Relsart/WaterLeakDefence_AVR/documentation/Schematics.pdf

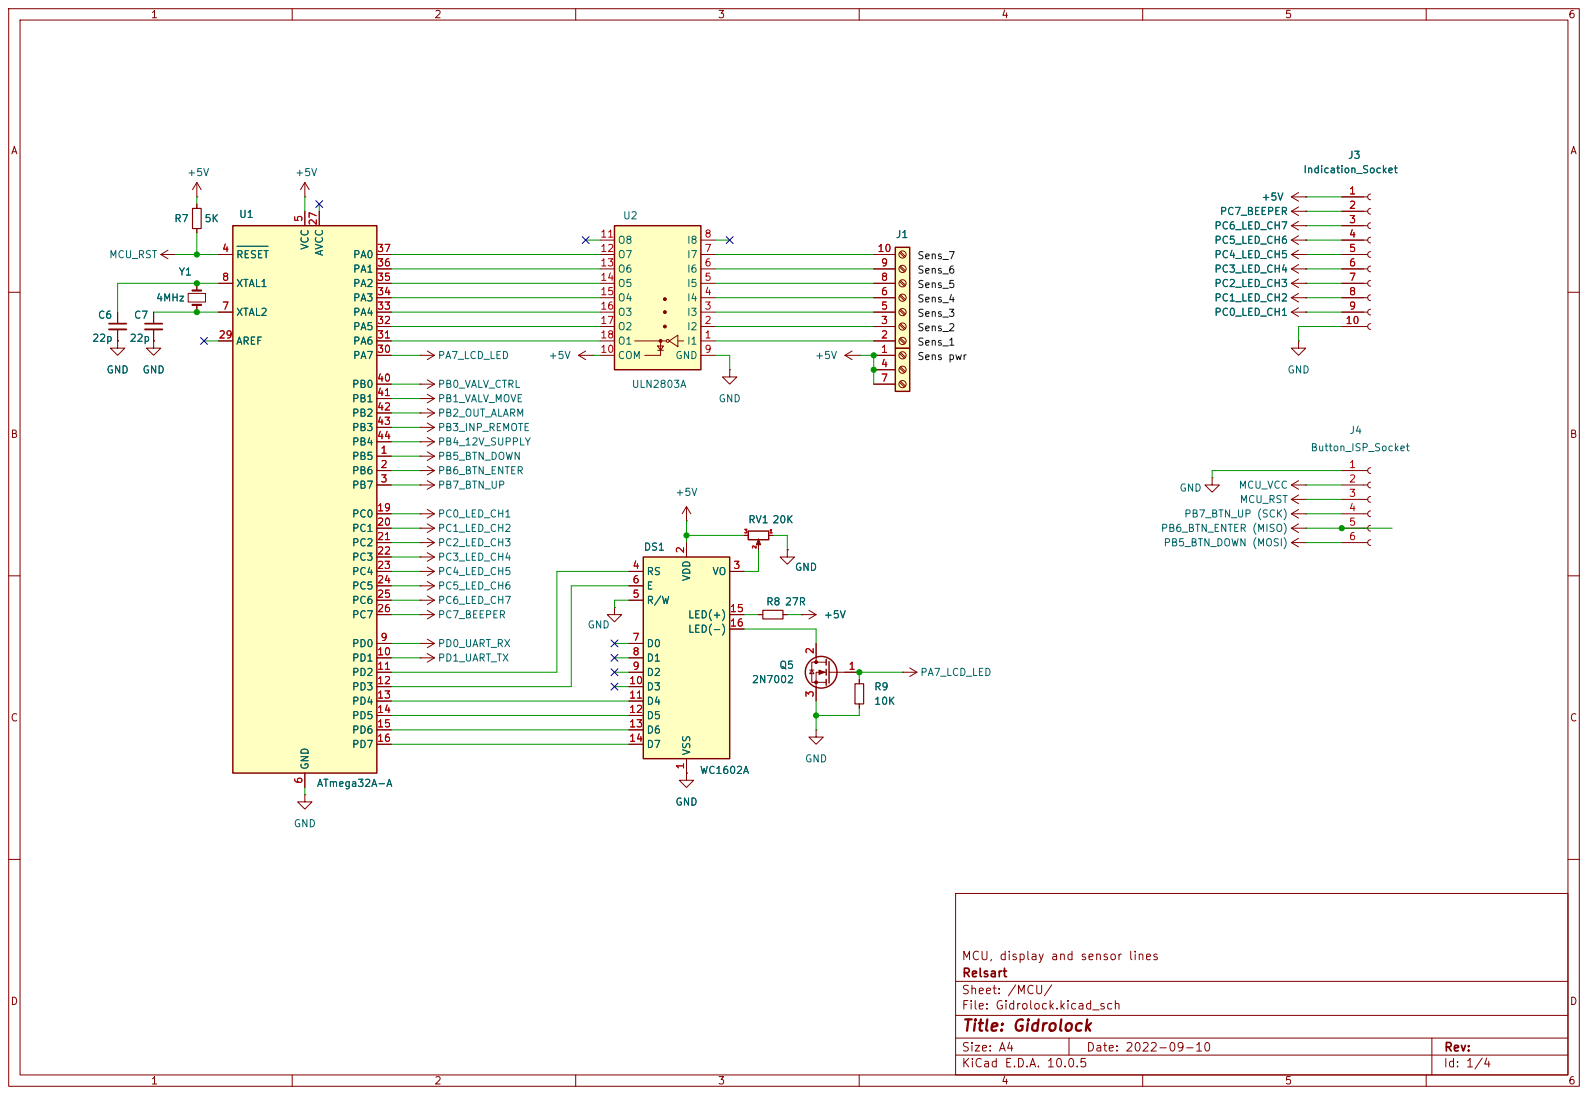
[picture p2: page 1]

MCU, display and sensor lines
Relsart
Sheet: /MCU/
File: Gidrolock.kicad_sch
Title: Gidrolock

Size: A4 | Rev:
KiCad E.D.A. 10.0.5 | Id: 1/4

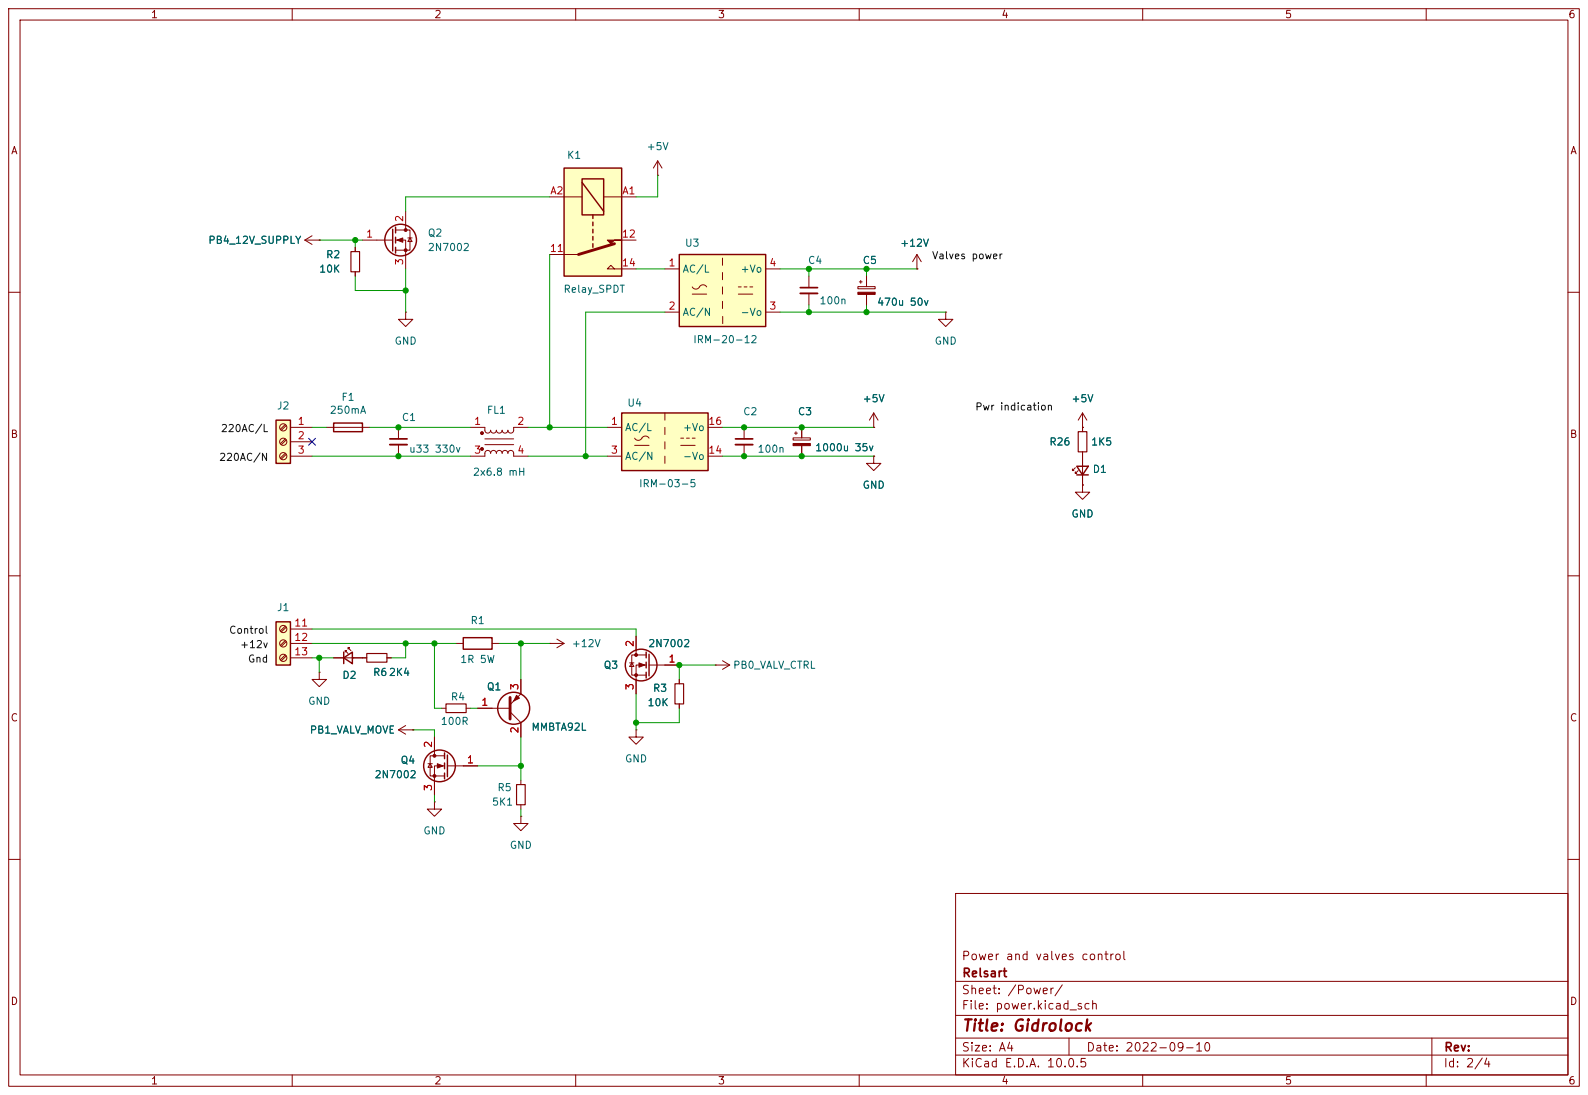
[picture p3: page 2]

Power and valves control R1

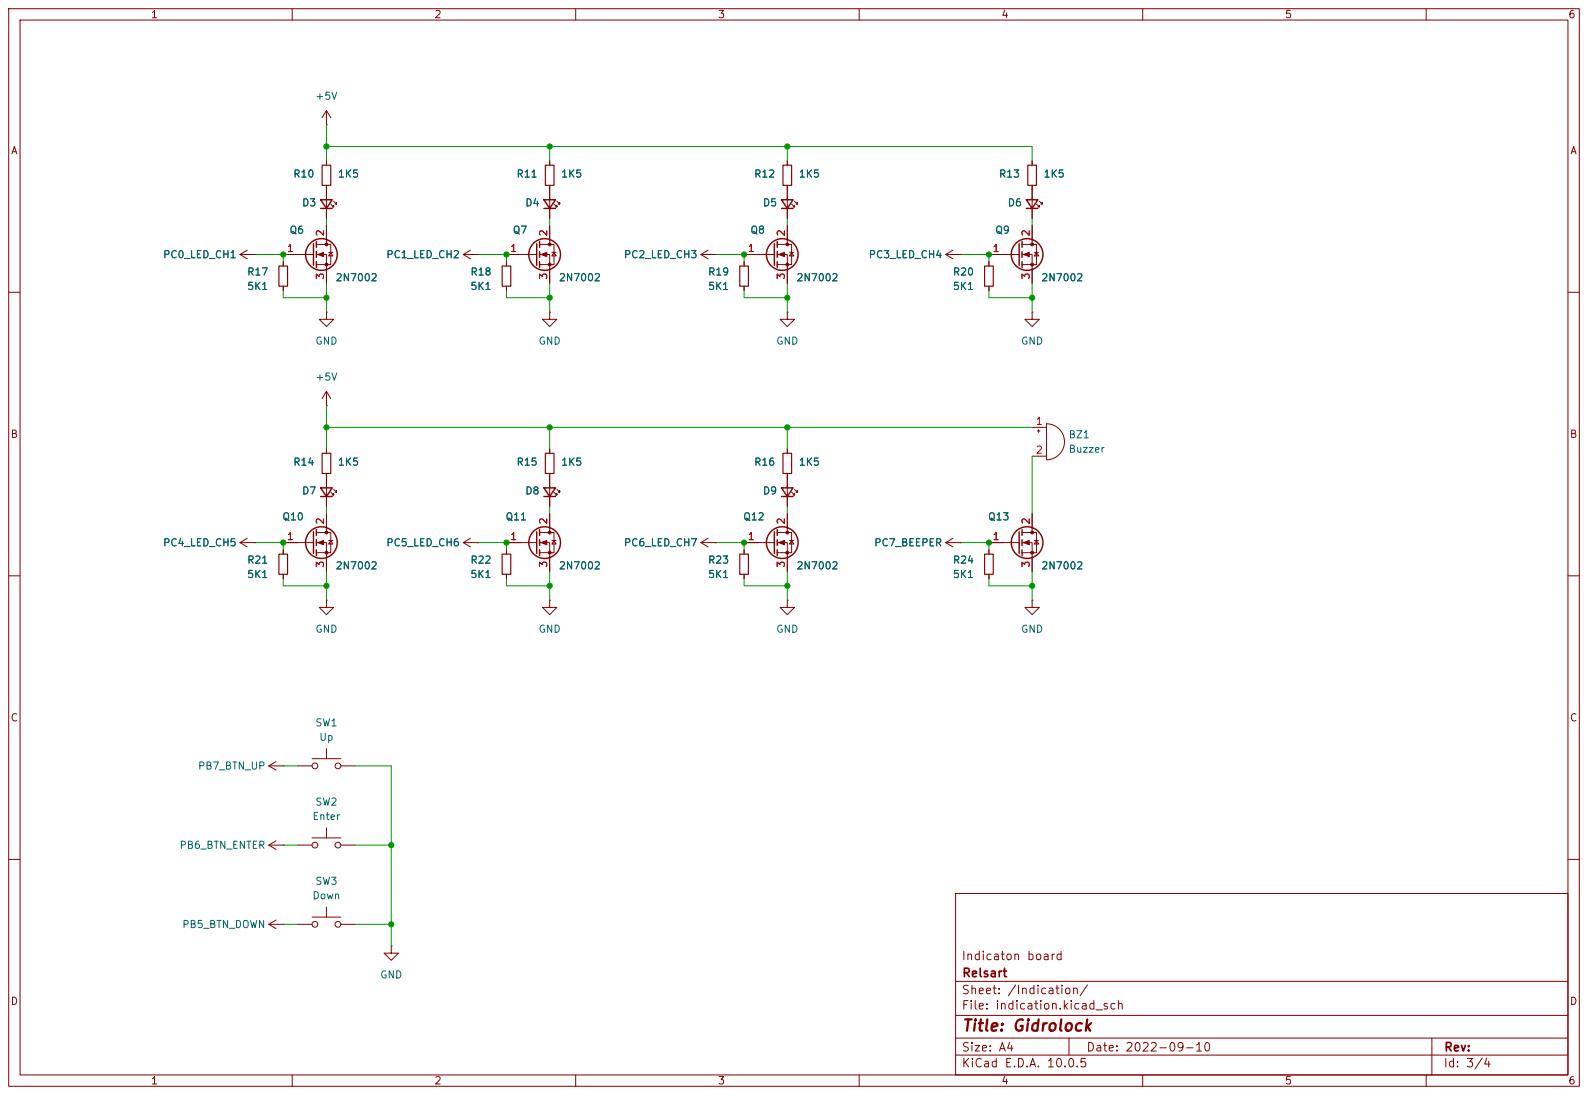
[picture p4: page 3]

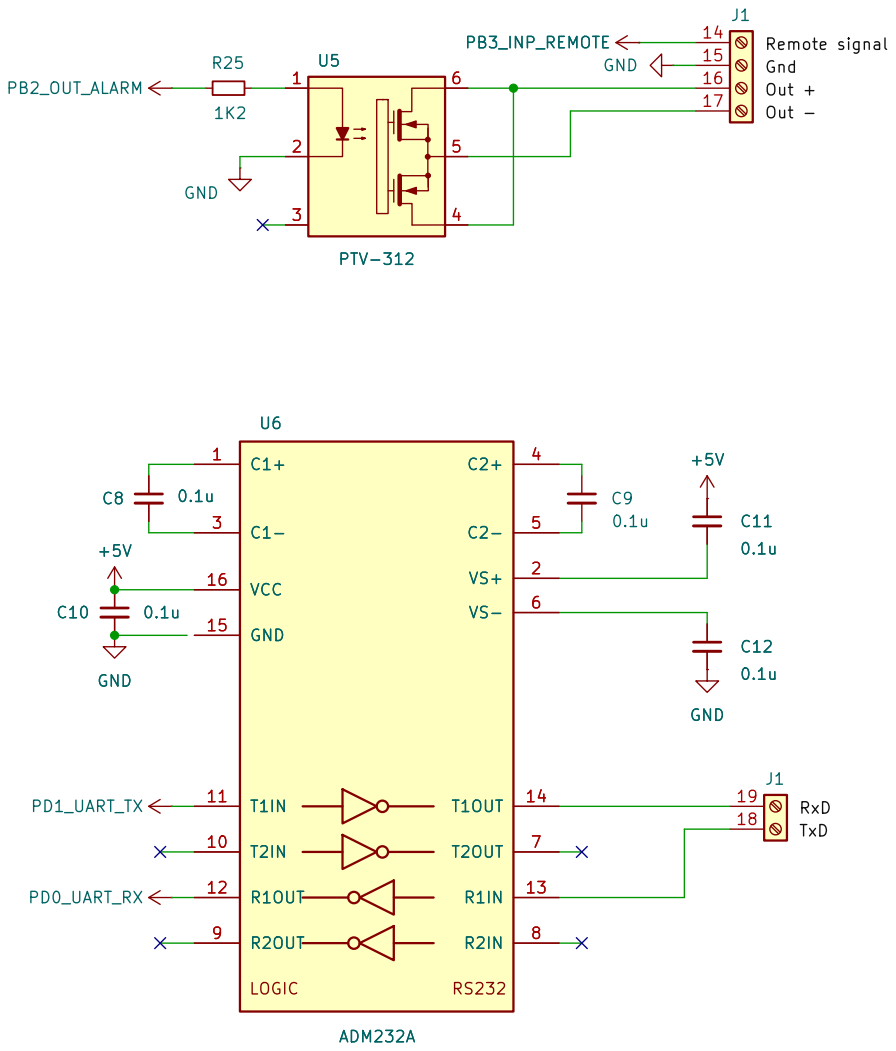
[picture p5: page 4]
