Relsart/WaterLeakDefence_AVR/(list of files, drawings)

Other design files:
documentation/Board.lay6
